eSpark-Consulting-Group/bionic-battery-pcb/docs/Concept Enclosure Design of battery.pdf

# Concept Enclosure Design of battery

1. RGB-level status indicator
- Multi-color LED showing battery status (e.g., charging, low power).
2. RGB-level status indicator & Power button
- Dual-function LED (status display) and power button.
3. Switch mode button
- Toggles between battery modes (e.g., eco, performance).
4. USB Type-C interface
- Reversible port for charging/data transfer.

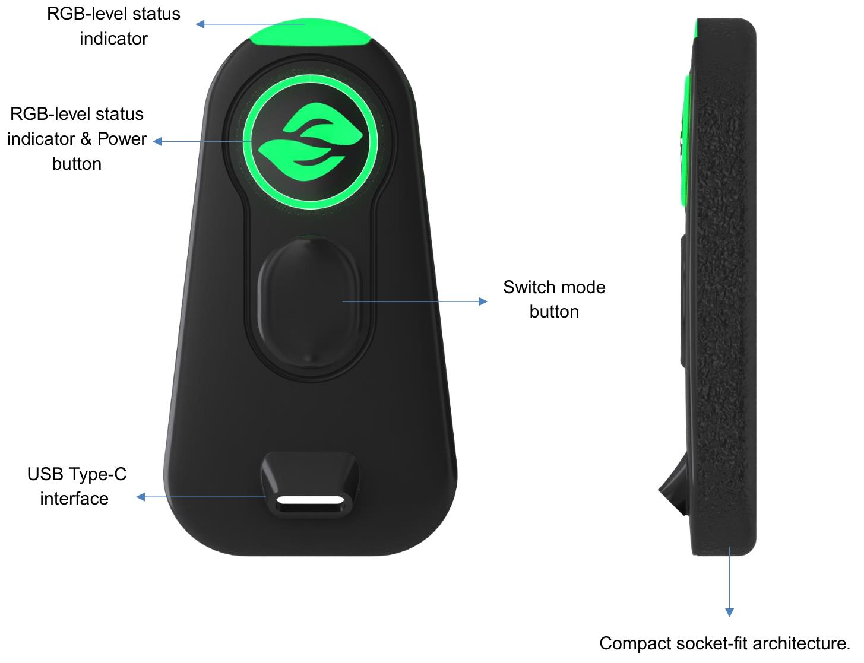
[picture p1: figure]

5. Compact socket-fit

architecture

- Space-efficient design

for secure socket

integration.
