eSpark-Consulting-Group/bionic-battery-pcb/docs/layout.jpg

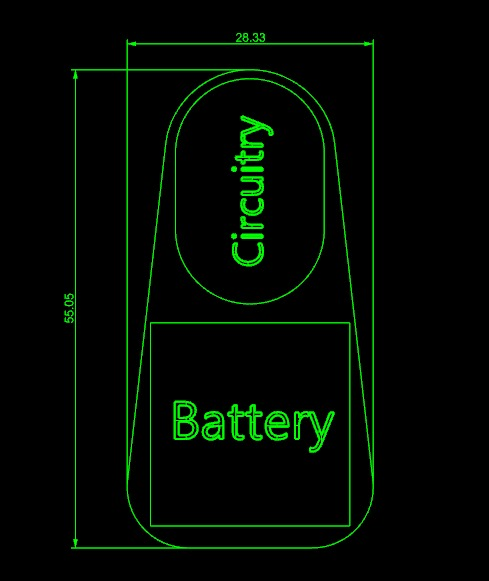
docs/layout.jpg
