eSpark-Consulting-Group/bionic-battery-pcb/Design files/Battery bank/BOM/Client-BOM-Battery bank.xlsx

# | Item Type | Designator | Description | Footprint | Manufacturer Part Number | Manufacturer | Value | Quantity | Remarks
1 | Capacitor | C1, C13, C25, C26, C27, C28, C32, C33, C35, C38, C42, C44 | CAP CER 0.1UF 25V X6S 0201 | CAP-0201 | GRM033C81E104KE14D | Murata | 0.1uF | 12
2 | Capacitor | C2, C3, C4, C5, C6, C21, C23, C41, C43 | CAP CER 10UF 10V X5R 0402 | Cap-0402 | CC0402MRX5R6BB106 | Yageo | 10uF | 9
3 | Capacitor | C7, C8, C14, C15, C16 | CAP CER 10UF 25V X5R 0603 | CAP-0603 | TMK107BBJ106MA-T | Taiyo Yuden | 10uF | 5
4 | Capacitor | C9 | CAP CER 0.1UF 50V X7R 0402 | cap-0402 | C1005X7R1H104KT000F | TDK | 100nF | 1
5 | Capacitor | C10, C24, C34 | CAP CER 1UF 16V X5R 0201 | CAP-0201 | GRM033R61C105ME15D | Murata | 1uF | 3
6 | Capacitor | C12 | CAP CER 10UF 10V X5R 0402 | Cap-0402 | CL05A106MP5NUNC | Samsung | 10uF | 1
7 | Capacitor | C17, C39, C40, C45 | CAP CER 4.7UF 16V X5R 0402 | Cap-0402 | CL05A475MO5NUNC | Samsung | 4.7uF | 4
8 | Capacitor | C18 | CAP CER 10000PF 25V X7R 0402 | Cap-0402 | VJ0402Y103JXXAC | Vishay Vitramon | 1nF | 1
9 | Capacitor | C20, C22, C29 | CAP CER 2.2UF 10V X5R 0201 | CAP-0201 | CC0201MRX5R6BB225 | Yageo | 2.2uF | 3
10 | Capacitor | C30, C31 | CAP CER 30PF 50V C0G/NPO 0201 | Cap-0201 | CC0201FRNPO9BN300 | Yageo | 30pF | 2
11 | Capacitor | C36, C37 | CAP CER 0.047UF 50V X7R 0402 | Cap-0402 | CC0402KRX7R9BB473 | Yageo | 47nF | 2
12 | Header | J2 | Gold 1A Straight Policy 1mm 4P 3.9mm -40℃~+105℃ 2.3mm 1.27mm Brass Black Single Row 1x4P Plugin,P=1.27mm Pin Headers ROHS | Custom | ZX-PZ1.27-1-4PZZ | Megastar | - | 1
13 | Inductor | L1 | FIXED IND 1UH 11A 11.9MOHM SM | Custom | XFL4020-102MEC | Coilcraft | 1uH | 1
14 | Inductor | L2 | 1.55A 4.7uH ±20% SMD Power Inductors ROHS | Custom | SLO252012F4R7MTT | Sunltech Tech | 4.7uH | 1
15 | LED | LED1 | Green 520~535nm 0402 Light Emitting Diodes (LED) RoHS | LED-0402 | 16-213/GHC-YR1S1/3T | Everlight Elec | - | 1
16 | Buzzers | LS1 | 80dB Passive (external drive) Electromagnetic Type 4kHz SMD,5x5mm Buzzers ROHS | FUET-5025 | FUET-5025 | FUET | - | 1
17 | MOSFETs | Q1 | MOSFET N-CH 20V 1A DFN1006-3 | DFN1006-3 | RV2C010UNT2L | Rohm | - | 1
18 | Resistor | R1 | RES 100 OHM 1% 1/16W 0402 | Res-0402 | RC0402FR-07100RL | Yageo | 100R | 1
19 | Resistor | R2, R3 | RES 4.7K OHM 1% 1/20W 0201 | Res-0201 | RC0201FR-074K7L | Yageo | 4.7K | 2
20 | Resistor | R4, R5, R16, R19, R20, R21, R22, R24, R25, R26, R28, R29 | RES SMD 10K OHM 1% 1/20W 0201 | Res-0201 | RC0201FR-0710KL | Yageo | 10K | 12
21 | Resistor | R6 | RES SMD 2.2K OHM 1% 1/16W 0402 | Res-0402 | RC0402FR-072K2L | Yageo | 2.2K | 1
22 | Resistor | R7 | RES 3K OHM 1% 1/16W 0402 | Res-0402 | RC0402FR-073KL | Yageo | 3K | 1
23 | Resistors | R8 | RES SMD 137K OHM 0.1% 1/16W 0402 | Res-0402 | RT0402BRD07137KL | Yageo | 137K | 1
24 | Resistor | R9 | RES SMD 100K OHM 0.1% 1/16W 0402 | Res-0402 | RT0402BRD07100KL | Yageo | 100K | 1
25 | Resistors | R10 | RES SMD 5.23K OHM 1% 1/16W 0402 | Res-0402 | CRCW04025K23FKED | Vishay | 5.23K | 1
26 | Resistor | R11 | RES SMD 30.1KOHM 0.1% 1/16W 0402 | Res-0402 | RT0402BRD0730K1L | Yageo | 30.1K | 1
27 | Resistor | R15 | RES 499 OHM 1% 1/20W 0201 | Res-0201 | RC0201FR-07499RL | Yageo | 499R | 1
28 | Resistor | R17 | RES 1M OHM 1% 1/20W 0201 | Res-0201 | RC0201FR-071ML | Yageo | 1M | 1
29 | Resistor | R18 | RES 100 OHM Thick Film 0201 1% 1/20W ±200ppm/°C Molded SMD SMD Paper T/R | Res-0201 | RC0201FR-07100RL | Yageo | 100R | 1
30 | Resistor | R23 | RES 5.1K OHM 1% 1/20W 0201 | Res-0201 | RC0201FR-075K1L | Yageo | 5.1K | 1
31 | Resistor | R27 | RES 1K OHM 1% 1/20W 0201 | Res-0201 | RC0201FR-071KL | Yageo | 1K | 1
32 | Switch | SW1 | No Without bracket 50mA 2.5mm 200,000 Times 1.6N 12V 1.6mm 0.55mm Vertical welding SPST SMD-4P,2.5x1.6mm Tactile Switches ROHS | Custom | HX TS152605A 160gf | hanxia | - | 1
33 | Switch | SW2 | SWITCH TACTILE SPST-NO 0.05A 12V | Custom | B3U-1000P | Omron | - | 1
34 | IC | U1 | Charger IC Lithium Ion/Polymer 29-VQFN-HR (4x4) | 29-VQFN-HR (4x4) | BQ25792RQMR | Texas Instruments | - | 1
35 | IC | U2 | IC REG LINEAR 3.3V 1A 8DFN | DFN-8(1.2x1.6) | LD56100DPU33R | STMicroelectronics | - | 1
36 | IC | U3 | ARM Cortex-M3 STM32 F1 Microcontroller 32-Bit 72MHz 64kB FLASH LQFP48 STM32F103C8T6 | 48-LQFP (7x7)_ | STM32F103C8T6 | STMicroelectronics | - | 1
37 | IC | U4 | IC BATT MON LI-ION 1CELL 8WLP | 8-WLP (1.66x0.92) | MAX17048X+T10 | Analog Devices Inc./Maxim Integrated | - | 1
38 | IC | U5 | IC BUF NON-INVERT 5.5V SOT23-5 | SOT-23-5 | SN74LV1T34DBVR | Texas Instruments | - | 1
39 | RGB LED | U6, U7 | Colorless transparence -40℃~+150℃ 正贴 RGB 120° 1010 Light Emitting Diodes (LED) ROHS | Custom | XL-1010RGBC-WS2812B | XINGLIGHT | - | 2
40 | IC | U8 | IC REG BOOST 5V 200MA SC70-6 | SC-70-6 | TPS61222DCKR | Texas Instruments | - | 1
41 | IC | U9 | SOIC-8-EP Battery Management ICs ROHS | 8-SO-EP_ | XB8886A | XySemi | - | 1
42 | Crystal | X1 | 8MHz Surface Mount Crystal 20pF ±10ppm ±30ppm SMD5032 Crystals ROHS | SMD5032 | 0153G2-8.000F20DTNJL | HCI | 8MHz | 1
43 | Periphrals | - | 1pc USB Type C Vertical Patch Board 24pin Data Plug Band PCB 24P Male Head 14P Female Socket Usb C Connector | - | Female Socket Usb C Connector | - | - | 1 | Aliexpress (https://vi.aliexpress.com/item/1005007427196212.html)
