eSpark-Consulting-Group/bionic-battery-pcb/Design files/Battery bank/Step files/Battery Bank_PCB.step

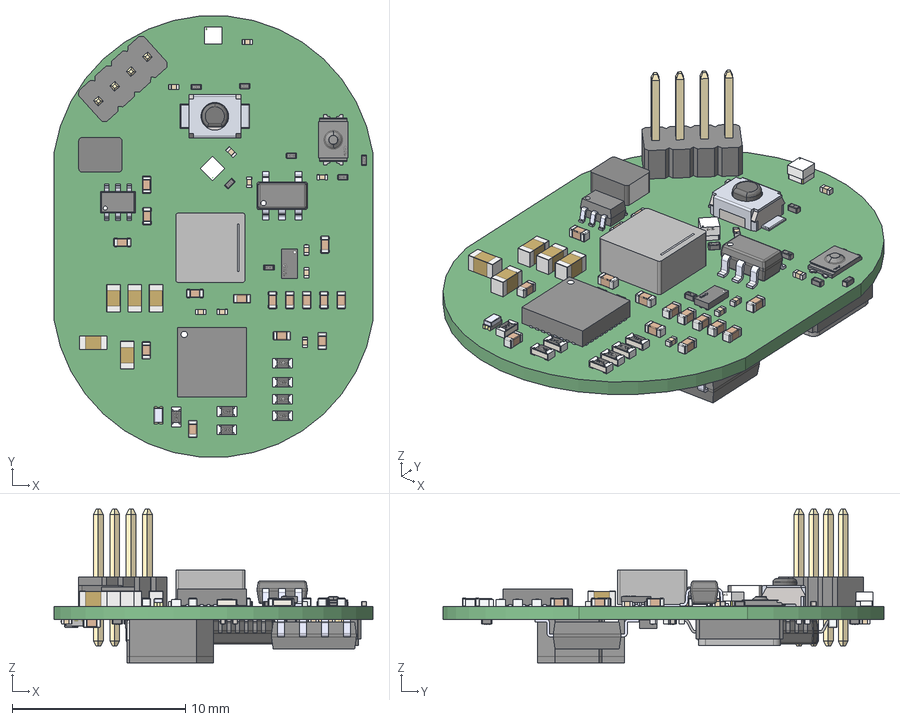
[picture p3: CAD file, 2025-06-23]
Design files/Battery bank/Step files/Battery Bank_PCB.step
18.4 x 25.4 x 8.86 mm
User_Library-0201(0603M)_Res x 19
XFL4020-102MEC--3DModel-STEP-56544
User_Library-SMD_Ceramic_Capacitors_0201_(0603)_AB x 20
User_Library-Capacitor_0402 x 18
SLO252012F4R7MTT
NX5032GA_12MHZ_AT-W
AP64501SP-13
COMPOUND.step x 2
SN74LV1T34DBVR
User_Library-P-LQFP48-7x7-0_50
User_Library-OMRON_B3U1000P
User_Library-RES_1005-0402 x 7
MMBT3904LP-7--3DModel-STEP-56544
User_Library-LED-0402
User_Library-CAPC1608X09 x 5
