eSpark-Consulting-Group/bionic-battery-pcb/docs/Battery-PCB-Layout.dxf

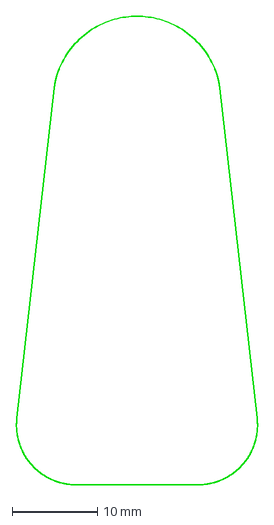
[picture p4: CAD file, 2025-05-14]
docs/Battery-PCB-Layout.dxf
28.3 x 55.1 mm
