eSpark-Consulting-Group/bionic-battery-pcb/Design files/Battery bank/Schematic/Battery bank.pdf

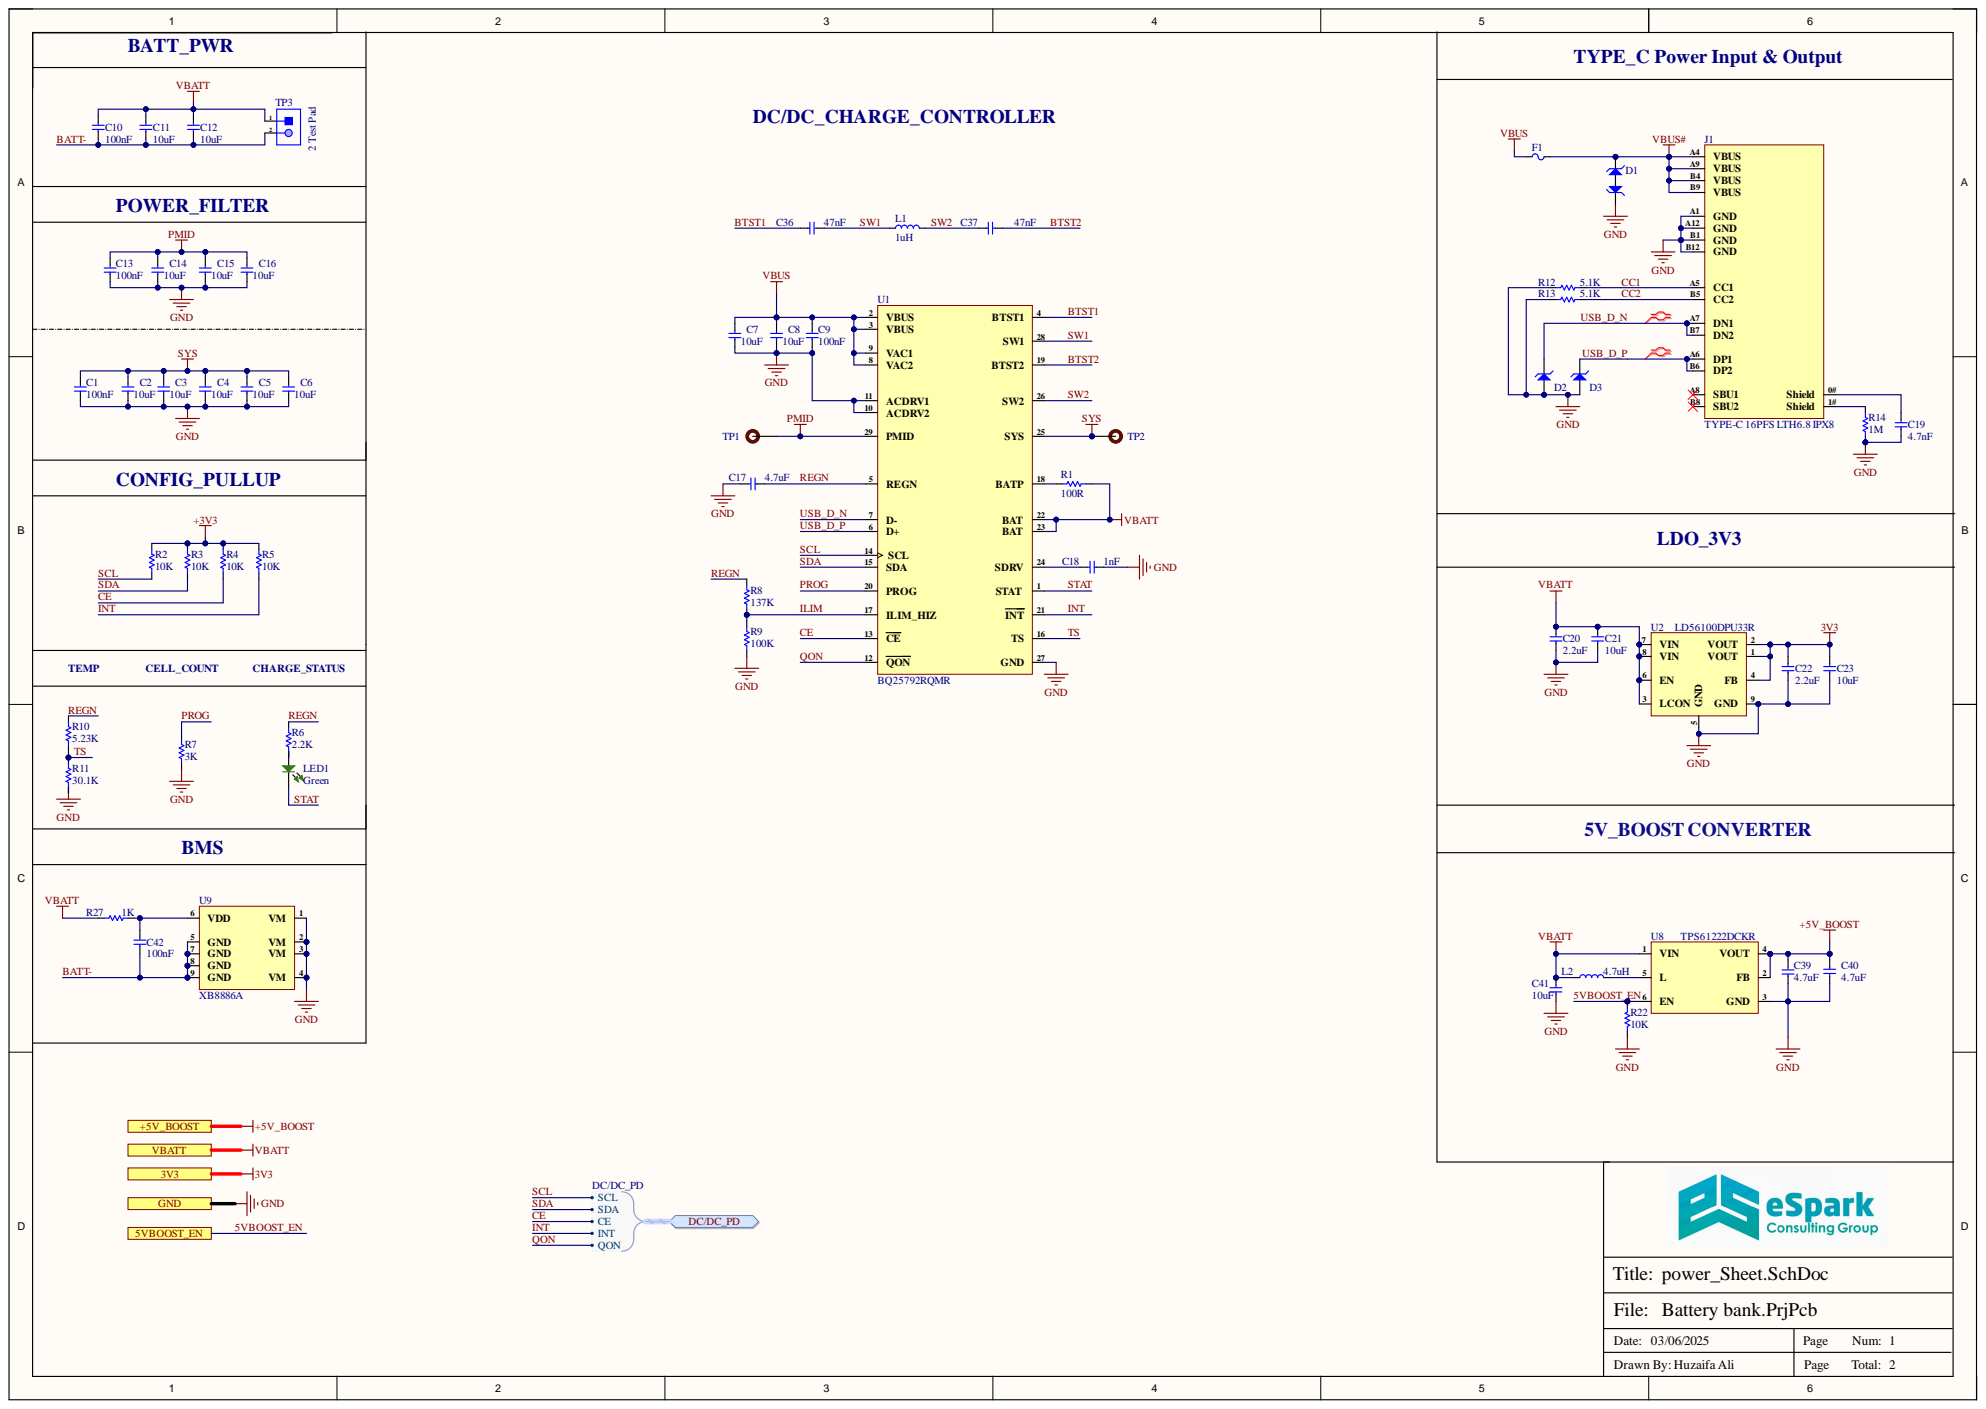
[picture p5: page 1]

Date: 0 3 /0 6 /2 0 2 5 | Pag e N u m : 12

D raw n B y : H uzai fa A l i | Pag e To tal :

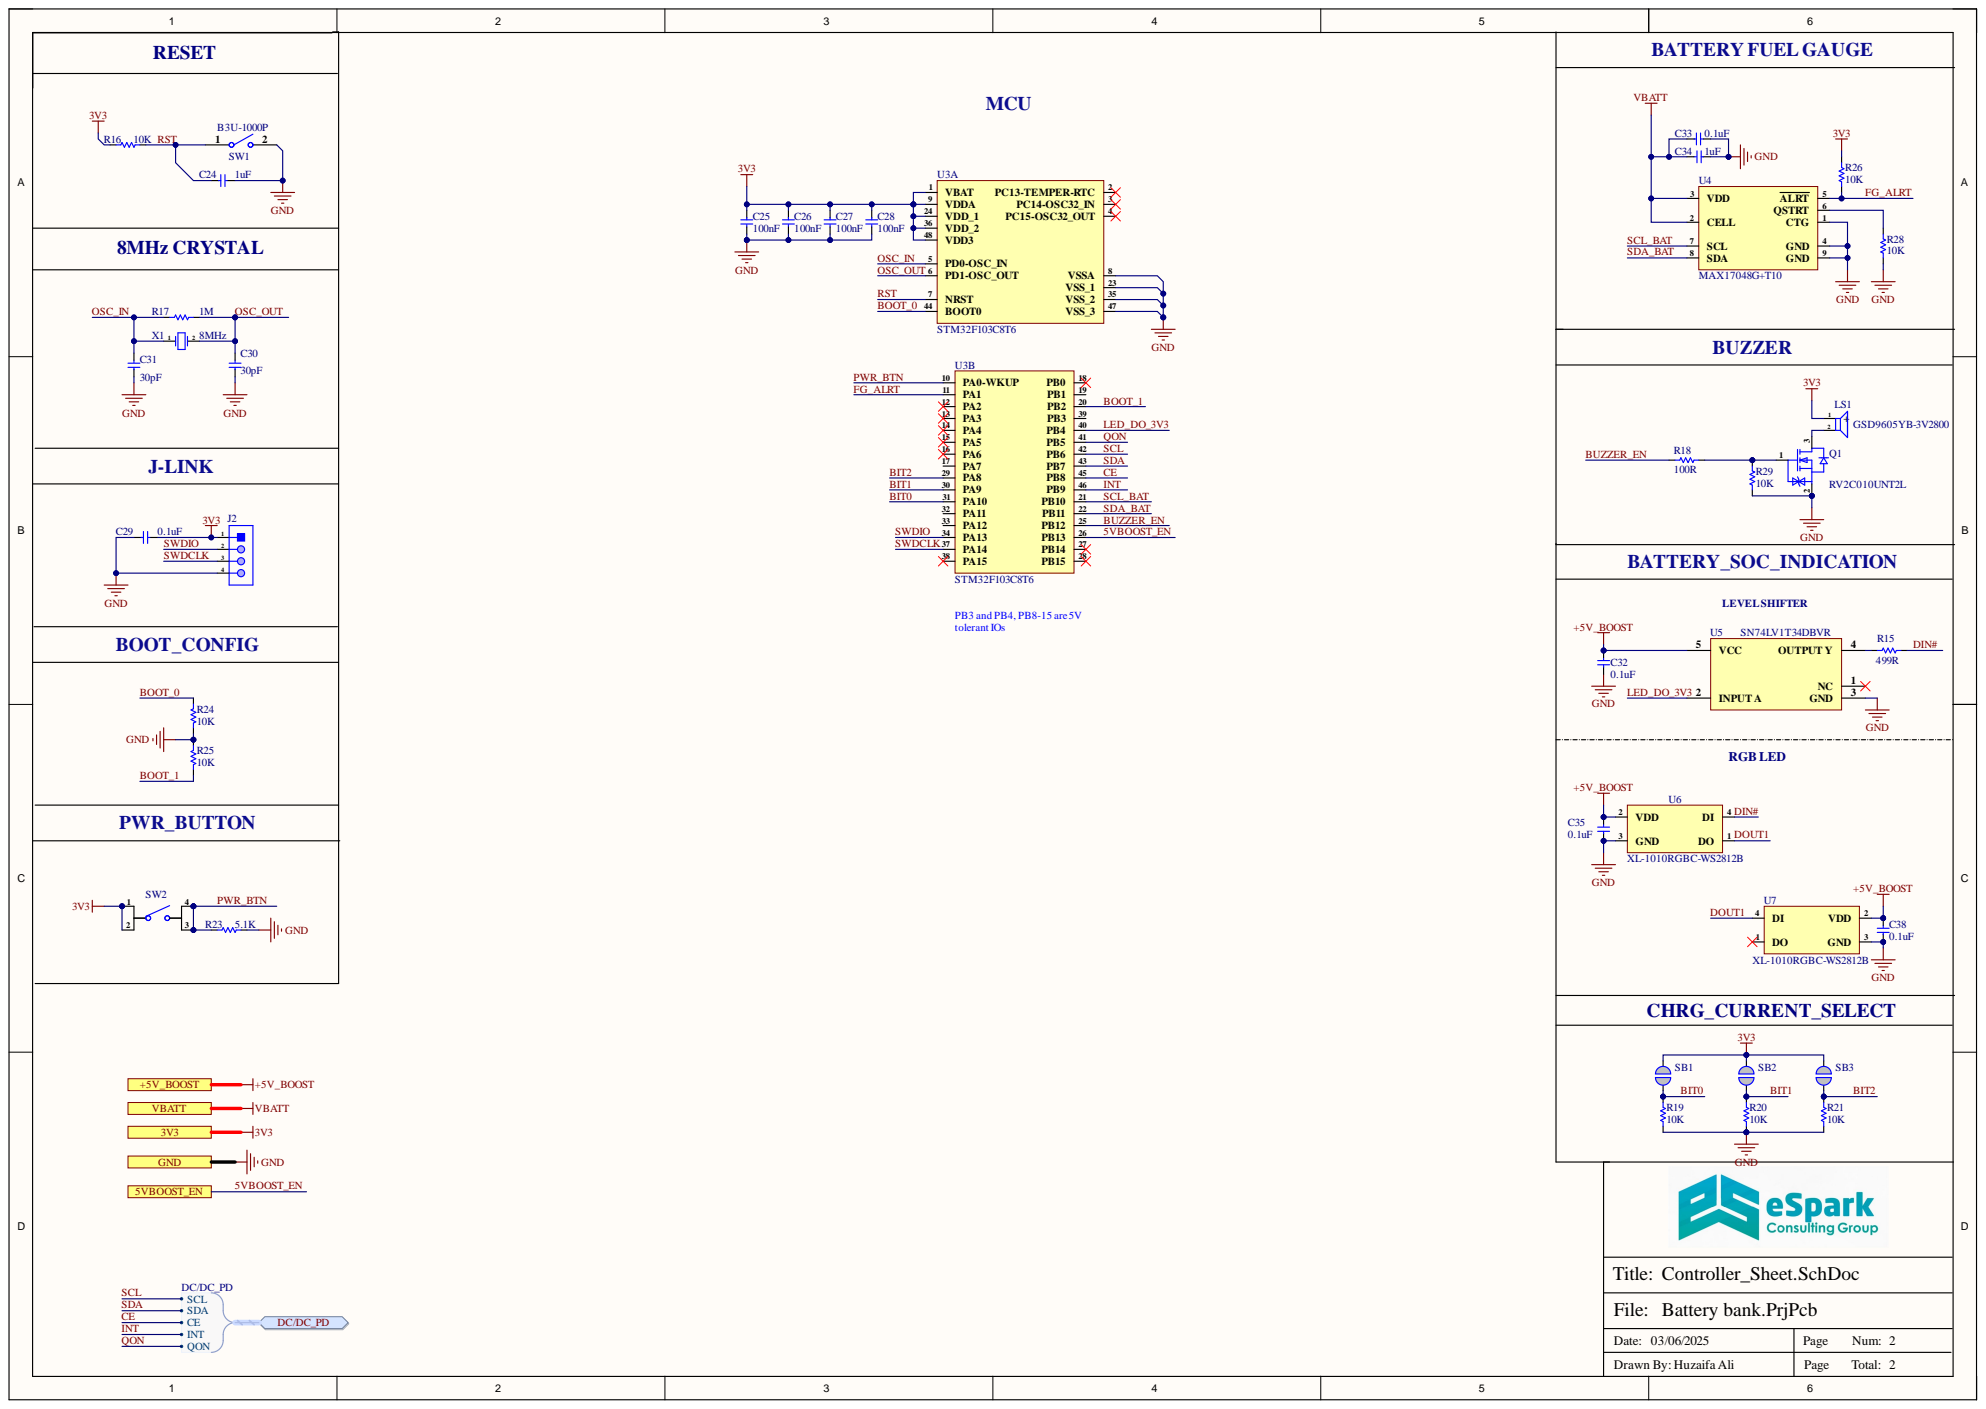
[picture p6: page 2]

Date: 0 3 /0 6 /2 0 2 5 | Pag e N u m : 22

D raw n B y : H uzai fa A l i | Pag e To tal :
