eSpark-Consulting-Group/bionic-battery-pcb/(list of files, drawings)

Other design files:
Design files/Battery bank/Battery bank.PrjPcb
Design files/Battery bank/Battery Bank_PCB.PcbDoc
Design files/Battery bank/Controller_Sheet.SchDoc
Design files/Battery bank/power_Sheet.SchDoc
Design files/USB_C PCB/PCB.PcbDoc
Design files/USB_C PCB/USB-C _Sheet.SchDoc
Design files/USB_C PCB/USB-C_PCB.PrjPcb
