eSpark-Consulting-Group/bionic-battery-pcb/(commit log)

2025-05-14 dxf and estimated layout picture added.
    [Battery-PCB-Layout.dxf]
2025-05-14 concept enclosure doc added
2025-05-20 #2 schematic files added (in progress)
    [Battery bank.PrjPcb, Sheet1.SchDoc]
2025-05-23 #2 updated schematic design
    [Battery bank.PrjPcb, Controller_Sheet.SchDoc, Sheet1.SchDoc, power_Sheet.SchDoc]
2025-05-26 #2 Updated Schematic design ( in progress)
    [Battery bank.PrjPcb, Controller_Sheet.SchDoc, power_Sheet.SchDoc]
2025-05-30 #2 Updated Schematic design (done)
    [Controller_Sheet.SchDoc, power_Sheet.SchDoc]
2025-06-03 #2 Updated schematic design (updated Buzzer)
    [Battery bank.PrjPcb, Controller_Sheet.SchDoc, PCB1.PcbDoc, power_Sheet.SchDoc]
2025-06-03 #3 updated PCB design
    [Battery Bank_PCB.PcbDoc, Battery bank.PrjPcb, PCB1.PcbDoc]
2025-06-04 #3 Updated PCB design
    [Battery Bank_PCB.PcbDoc, Controller_Sheet.SchDoc, power_Sheet.SchDoc]
2025-06-19 #3 Added TYPE-C PCB
    [Battery Bank_PCB.PcbDoc, PCB.PcbDoc, USB-C _Sheet.SchDoc, USB-C_PCB.PrjPcb, power_Sheet.SchDoc]
2025-06-23 #3 Updated PCB
    [Battery Bank_PCB.PcbDoc, Battery Bank_PCB.step]
2025-06-23 #3 Updated PCB designs
    [Battery Bank_PCB.PcbDoc, Battery Bank_PCB.step, PCB.PcbDoc, USB-C _Sheet.SchDoc]
2025-07-11 Client BOM Added.
    [Client-BOM-Battery bank.xlsx]
